khushhallchandra/Inverted-pendulum/data_recorded/README

This folder contains the following values which can be used for further analysis
time	alpha	theta
