khushhallchandra/Inverted-pendulum/eagle/bottom.pdf

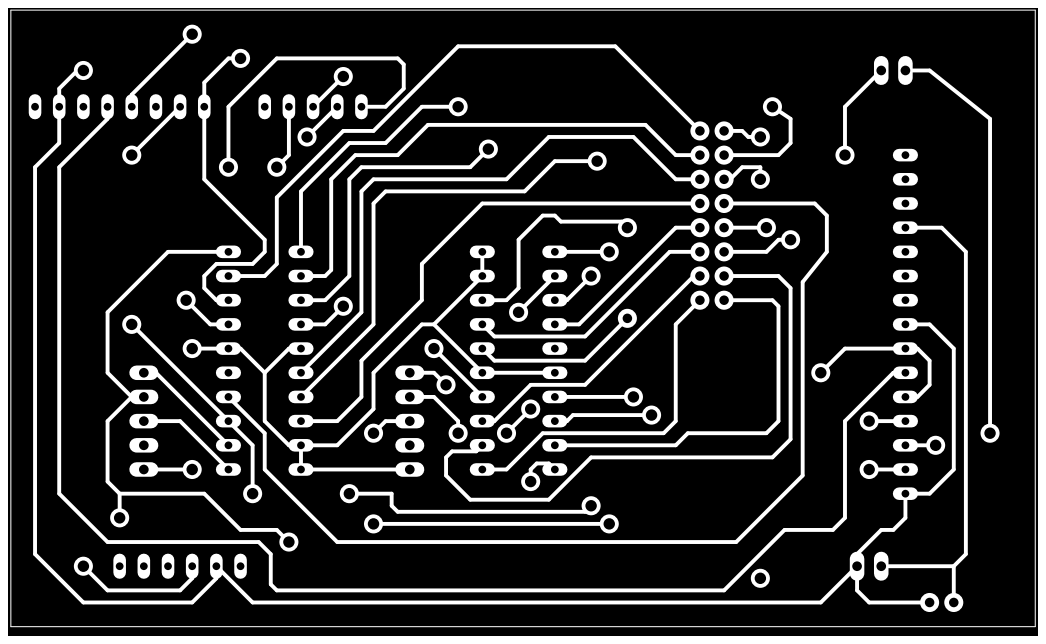
[picture p14: page 1]
