khushhallchandra/Inverted-pendulum/eagle/top.pdf

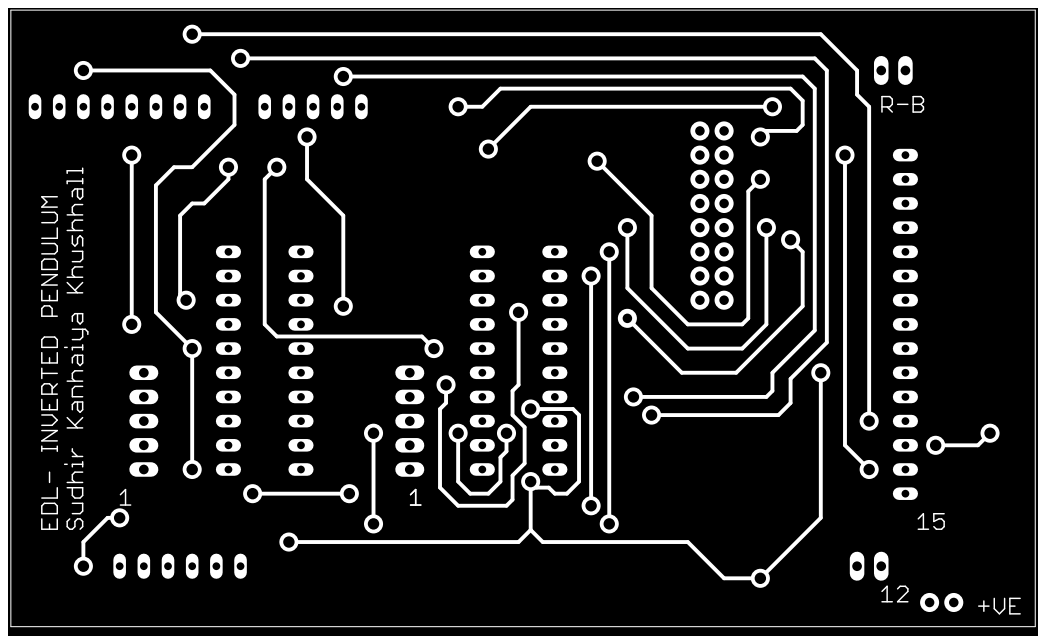
[picture p15: page 1]
