khushhallchandra/Inverted-pendulum/eagle/edlinv.brd

## EAGLE design eagle/edlinv.brd (2016-04-14)

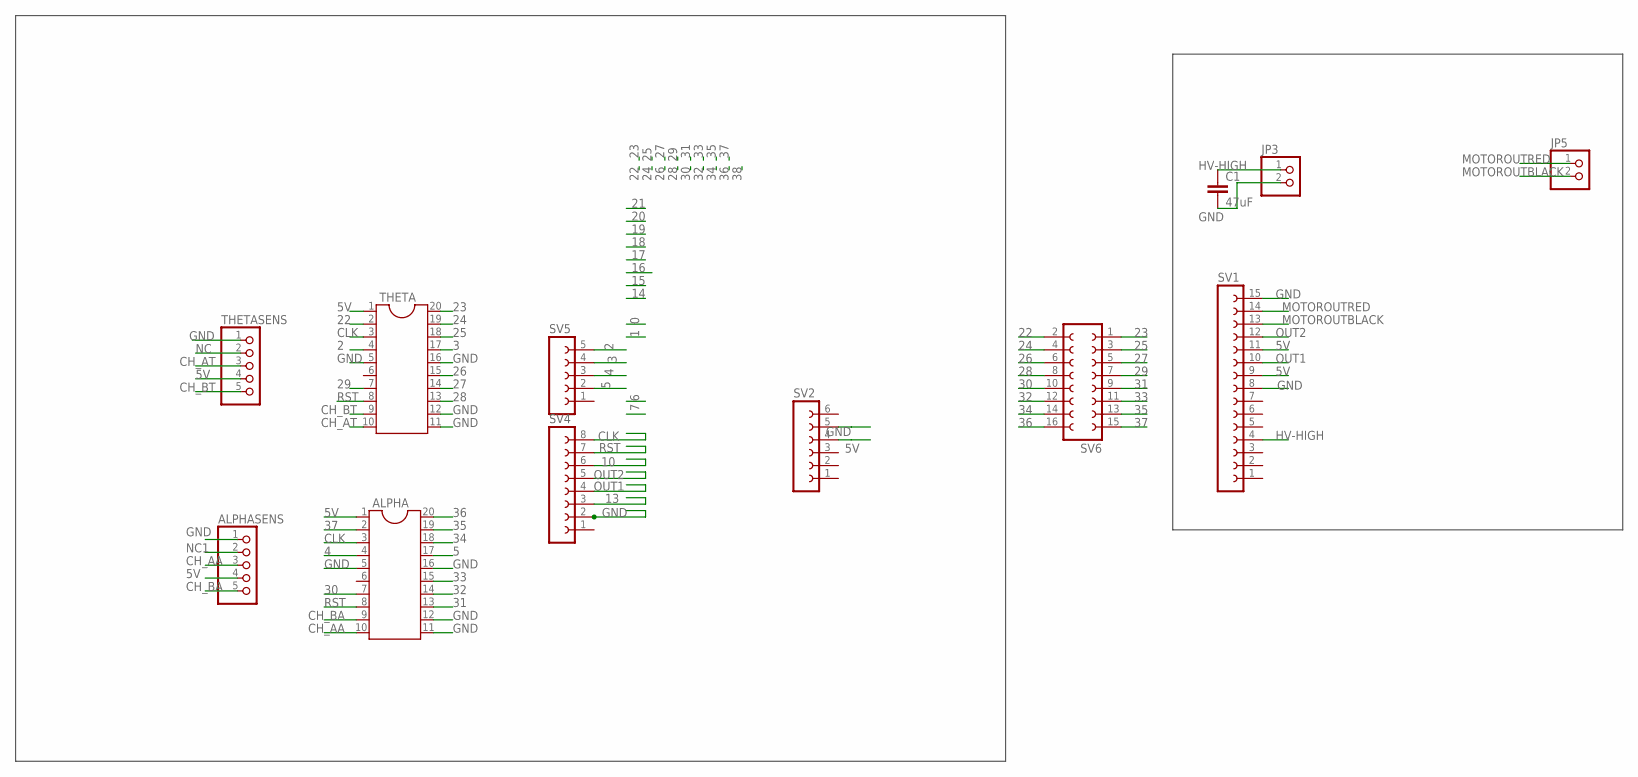
[picture p16: schematic edlinv.sch]

Parts:
ALPHA: DIL20
ALPHASENS: PINHD-1X5; 1X05
C1: 47uF; C025-025X050
JP3, JP5: PINHD-1X2; 1X02
SV1: FE15-1; FE15
SV2: FE06-1; FE06
SV4: FE08-1; FE08
SV5: FE05-1
SV6: FE08-2
THETA: DIL20
THETASENS: PINHD-1X5; 1X05

Connections:
2: SV5.5, THETA.4
3: SV5.4, THETA.17
4: ALPHA.4, SV5.3
5: ALPHA.17, SV5.2
5V: ALPHA.1, ALPHASENS.4, SV1.9, SV1.11, SV2.4, THETA.1, THETASENS.4
10: SV4.6
13: SV4.3
22: SV6.2, THETA.2
23: SV6.1, THETA.20
24: SV6.4, THETA.19
25: SV6.3, THETA.18
26: SV6.6, THETA.15
27: SV6.5, THETA.14
28: SV6.8, THETA.13
29: SV6.7, THETA.7
30: ALPHA.7, SV6.10
31: ALPHA.13, SV6.9
32: ALPHA.14, SV6.12
33: ALPHA.15, SV6.11
34: ALPHA.18, SV6.14
35: ALPHA.19, SV6.13
36: ALPHA.20, SV6.16
37: ALPHA.2, SV6.15
CH_AA: ALPHA.10, ALPHASENS.3
CH_AT: THETA.10, THETASENS.3
CH_BA: ALPHA.9, ALPHASENS.5
CH_BT: THETA.9, THETASENS.5
CLK: ALPHA.3, SV4.8, THETA.3
GND: ALPHA.5, ALPHA.11, ALPHA.12, ALPHA.16, ALPHASENS.1, C1.2, JP3.2, SV1.8, SV1.15, SV2.5, SV4.2, THETA.5, THETA.11, THETA.12, THETA.16, THETASENS.1
HV-HIGH: C1.1, JP3.1, SV1.4
MOTOROUTBLACK: JP5.2, SV1.13
MOTOROUTRED: JP5.1, SV1.14
NC: THETASENS.2
NC1: ALPHASENS.2
OUT1: SV1.10, SV4.4
OUT2: SV1.12, SV4.5
RST: ALPHA.8, SV4.7, THETA.8

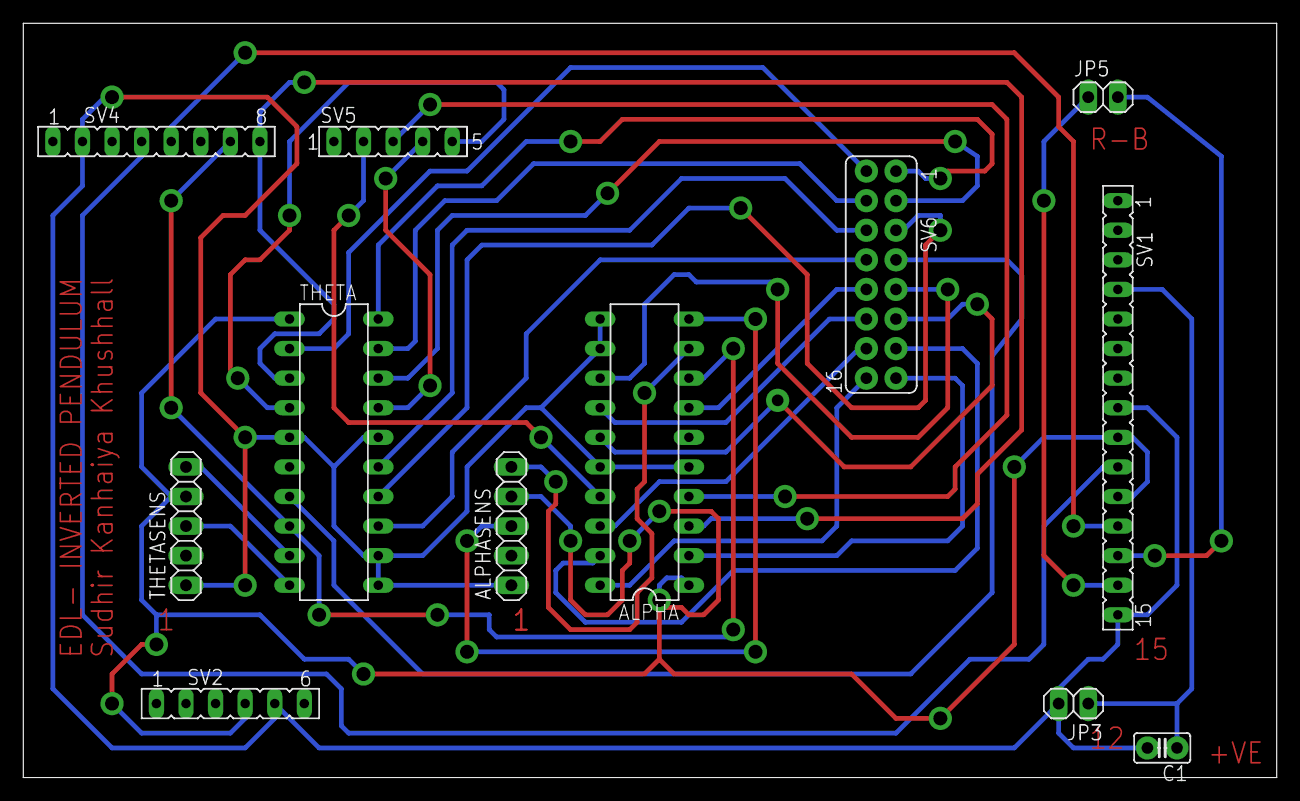
[picture p17: board edlinv.brd from above]

Board: 2 copper layers, 107.6 x 64.8 mm, 12 parts (0 on the bottom side), 33 nets.
