khushhallchandra/Inverted-pendulum/(commit log)

2016-03-08 LQR implementation. Increased the speed of interrupt
2016-04-14 Added PCB layout
    [edlinv.brd, edlinv.sch]
